hugo3132/EmlaLockSafe/README.md

# All documentation can be found under https://hugo3132.github.io/EmlaLockSafe/index.html

# EmlaLockSafe
This project is about controlling a cheap digital safe from a local hardware store using the API of emlalock https://www.emlalock.com. 

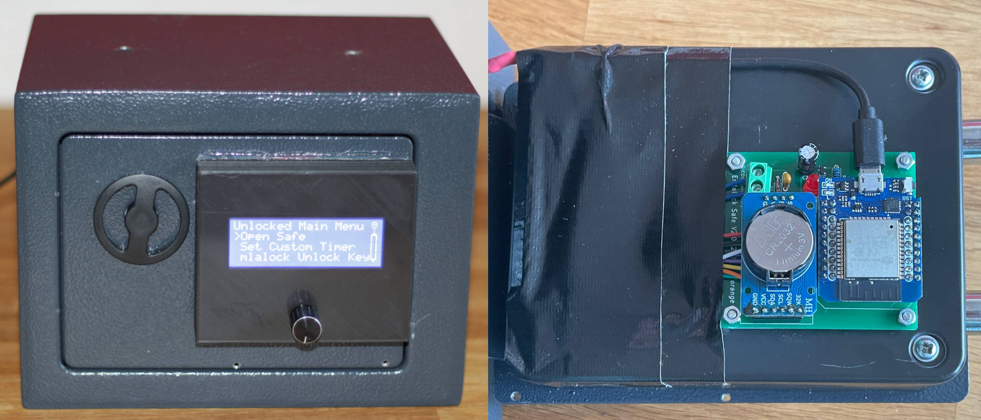
[picture p1: hardware/pictures/safe.jpg]
