hugo3132/EmlaLockSafe/hardware/Current Hardwarelist.txt

Ctrl:
https://www.amazon.de/AZDelivery-Bluetooth-Internet-Entwicklungsboard-kompatibel/dp/B08BTYCGVV

MicroUSB Breakout:
https://www.amazon.de/ZXUEZHENG-Adapterplatine-Micro-USB-Micro-USB-Schnittstelle-Breakout-Modul/dp/B07KS1RPMP

RTC:
https://www.amazon.de/AZDelivery-Real-Clock-DS3231-Parent/dp/B07ZQGBH14

Display:
https://www.amazon.de/AZDelivery-Bundle-2004-blau-Parent/dp/B07Z6CPTF4

Encoder: 
https://www.amazon.de/WayinTop-Encoder-Drehgeber-Drehwinkelgeber-Druckknopf/dp/B07T3672VK

Housing:
https://github.com/hugo3132/EmlaLockSafe/tree/master/hardware/3d%20printed%20parts/LCD%20Housing%20by%20hugo3132
source: https://cad.onshape.com/documents/5e5c868aceb5d7f8533767fd/w/02a796cf0a235e5fc50259cc/e/6ff6b7a15110ccacfdb04374

Brackets if you don't want to drill into the safe:
https://github.com/hugo3132/EmlaLockSafe/tree/master/hardware/3d%20printed%20parts/Emla%20Safe%20mounting%20brackets%20by%20naaitsab

Safe (must have some kind of electronic opening mechanism):
https://www.bauhaus.info/tresore/moebeleinsatztresor-security-box-mini/p/23519628
alternative: https://www.amazon.de/gp/product/B07X25MM4Y

Controller Board:
=================
1x Resistor 1k
1x Resitor 470
1x 5mm LED
1x Diode (e.g. 1N4148) 
1x MOSFET IRLML6244
1x 100µF Capacitor
1x 100nF Capacitor
Some connectors to connect the board to the modules (see pictures)
