hugo3132/EmlaLockSafe/hardware/pictures/coil.png

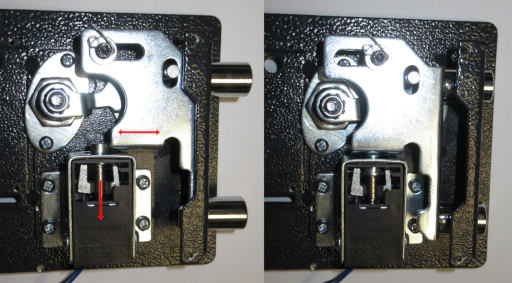
hardware/pictures/coil.png
