hugo3132/EmlaLockSafe/hardware/pictures/ControllerBoard.jpg

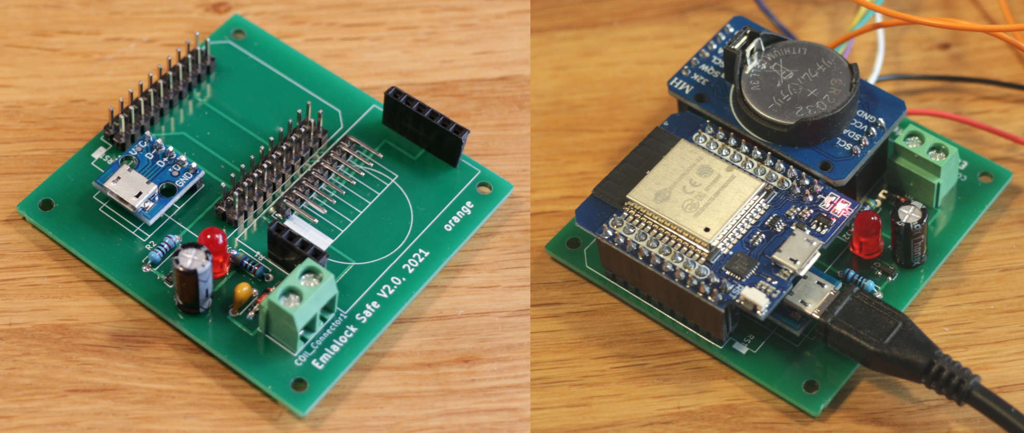
hardware/pictures/ControllerBoard.jpg
