hugo3132/EmlaLockSafe/hardware/pictures/DisplayModule_Back.jpg

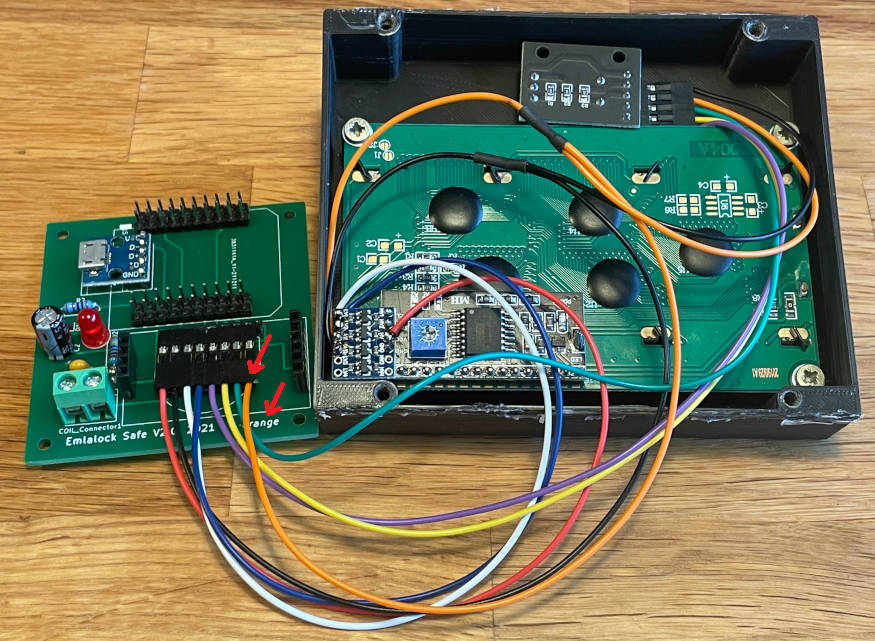
hardware/pictures/DisplayModule_Back.jpg
