hugo3132/EmlaLockSafe/hardware/pictures/DisplayModule_Front.jpg

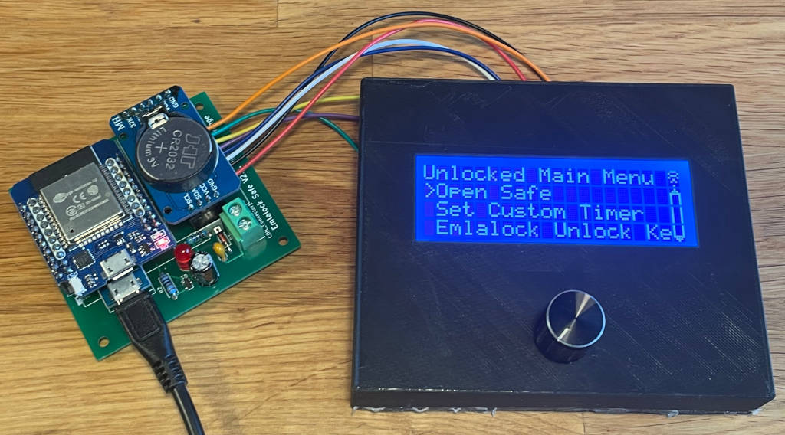
hardware/pictures/DisplayModule_Front.jpg
