hugo3132/EmlaLockSafe/hardware/pictures/FlashControllerBoard.png

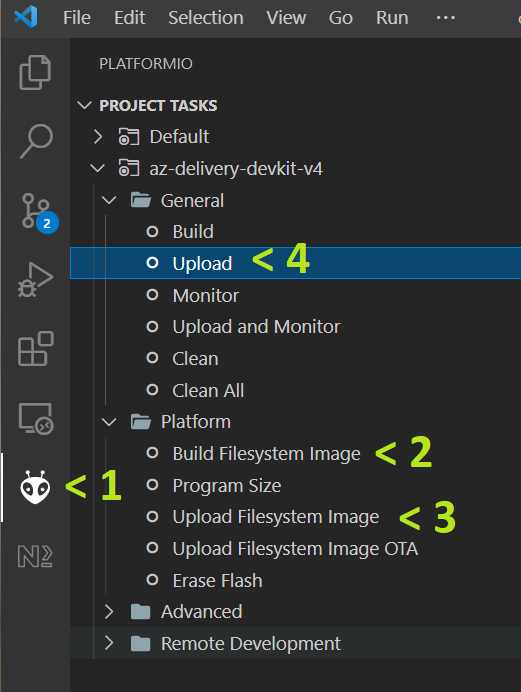
hardware/pictures/FlashControllerBoard.png
