hugo3132/EmlaLockSafe/hardware/3d printed parts/Emla Safe mounting brackets by naaitsab/EmlaSafe - Adapter Plate.jpg

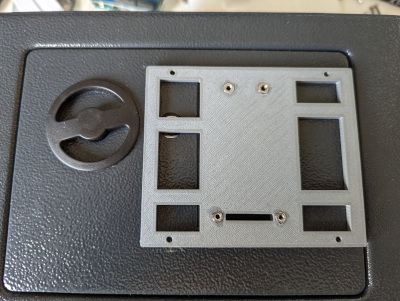
hardware/3d printed parts/Emla Safe mounting brackets by naaitsab/EmlaSafe - Adapter Plate.jpg
