hugo3132/EmlaLockSafe/hardware/3d printed parts/Emla Safe mounting brackets by naaitsab/EmlaSafe - PCB Holder.stl

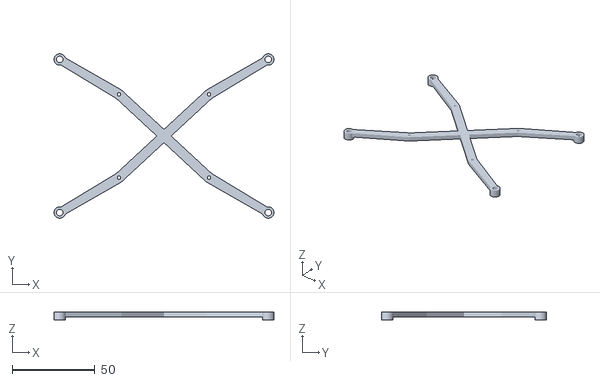
[picture p10: CAD file, 2022-04-09]
hardware/3d printed parts/Emla Safe mounting brackets by naaitsab/EmlaSafe - PCB Holder.stl
133.2 x 99.7 x 5.00
