hugo3132/EmlaLockSafe/hardware/3d printed parts/Housing v2 by hugo3132 inspired by naaitsab/Safe-Front Panel.stl

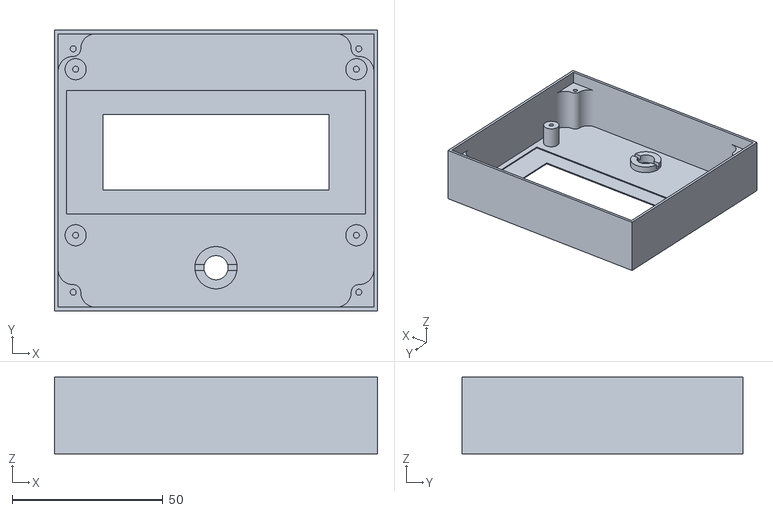
[picture p11: CAD file, 2022-05-24]
hardware/3d printed parts/Housing v2 by hugo3132 inspired by naaitsab/Safe-Front Panel.stl
107.0 x 93.0 x 25.5
