hugo3132/EmlaLockSafe/hardware/3d printed parts/LCD Housing by hugo3132/LCD_Housing.step

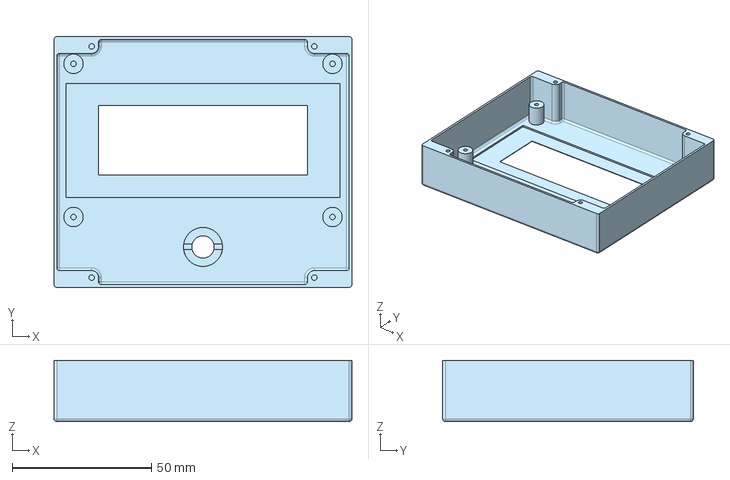
[picture p12: CAD file, 2022-04-09]
hardware/3d printed parts/LCD Housing by hugo3132/LCD_Housing.step
107.0 x 90.0 x 22.0 mm
