hugo3132/EmlaLockSafe/hardware/3d printed parts/Emla Safe mounting brackets by naaitsab/EmlaSafe - Adapter Plate Part 2.stl

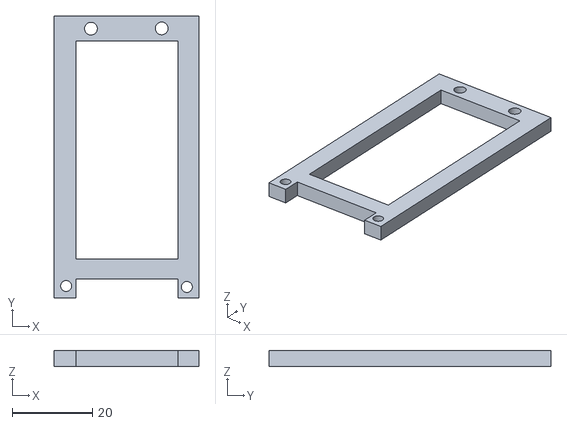
[picture p13: CAD file, 2022-04-09]
hardware/3d printed parts/Emla Safe mounting brackets by naaitsab/EmlaSafe - Adapter Plate Part 2.stl
36.2 x 70.5 x 4.00
