hugo3132/EmlaLockSafe/hardware/3d printed parts/Housing v2 by hugo3132 inspired by naaitsab/Safe.FCStd

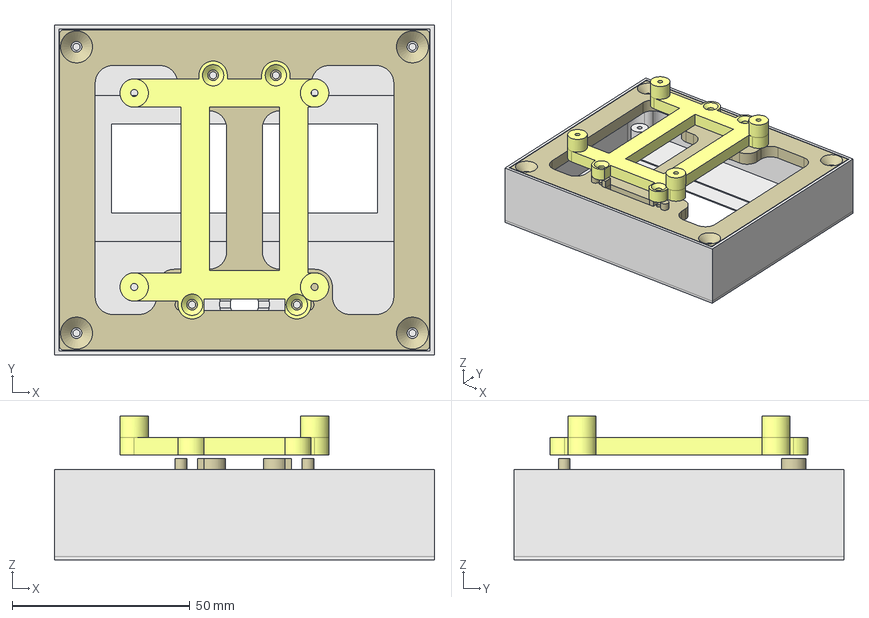
[picture p14: CAD file, 2022-05-24]
hardware/3d printed parts/Housing v2 by hugo3132 inspired by naaitsab/Safe.FCStd
107.0 x 93.0 x 40.5 mm
Front Panel
Mounting Frame 1
Mounting Frame 2
