hugo3132/EmlaLockSafe/hardware/3d printed parts/Emla Safe mounting brackets by naaitsab/EmlaSafe - Adapter Plate Part 1.stl

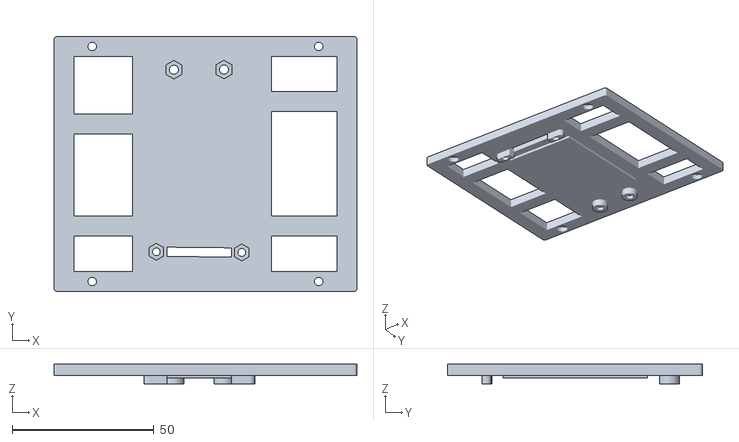
[picture p15: CAD file, 2022-04-09]
hardware/3d printed parts/Emla Safe mounting brackets by naaitsab/EmlaSafe - Adapter Plate Part 1.stl
107.0 x 90.0 x 7.00
