hugo3132/EmlaLockSafe/hardware/3d printed parts/Housing v2 by hugo3132 inspired by naaitsab/Safe-Mounting Frame 1.stl

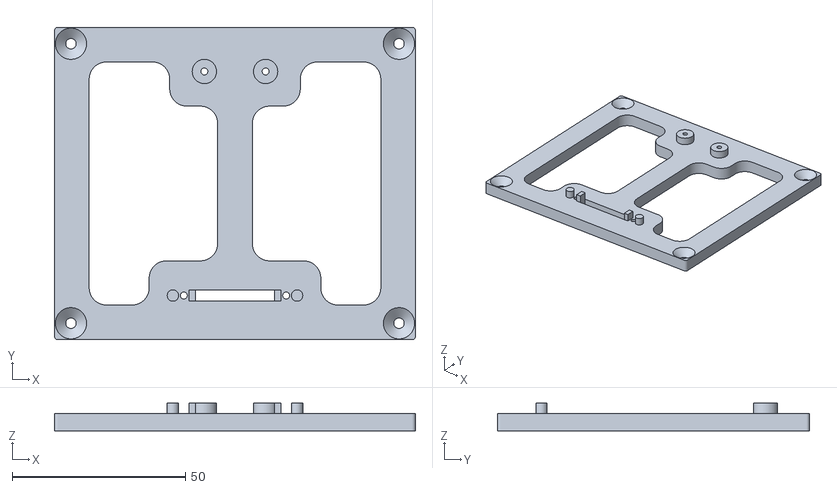
[picture p16: CAD file, 2022-05-24]
hardware/3d printed parts/Housing v2 by hugo3132 inspired by naaitsab/Safe-Mounting Frame 1.stl
104.1 x 90.1 x 8.00
