hugo3132/EmlaLockSafe/hardware/3d printed parts/Housing v2 by hugo3132 inspired by naaitsab/Safe-Mounting Frame 2.stl

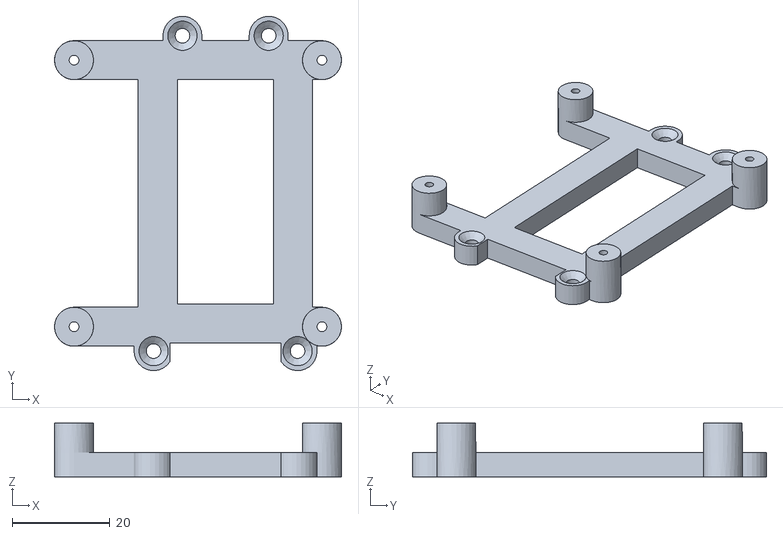
[picture p17: CAD file, 2022-05-24]
hardware/3d printed parts/Housing v2 by hugo3132 inspired by naaitsab/Safe-Mounting Frame 2.stl
58.8 x 72.6 x 11.0
