hugo3132/EmlaLockSafe/(list of files, cad)

Other CAD files:
hardware/3d printed parts/Emla Safe mounting brackets by naaitsab/EmlaSafe - Adapter Plate.f3d
hardware/3d printed parts/Emla Safe mounting brackets by naaitsab/EmlaSafe - PCB Holder .f3d
hardware/3d printed parts/LCD Housing by hugo3132/LCD_Housing.stl
