hugo3132/EmlaLockSafe/hardware/3d printed parts/Housing v2 by hugo3132 inspired by naaitsab/MountingInstructions.jpg

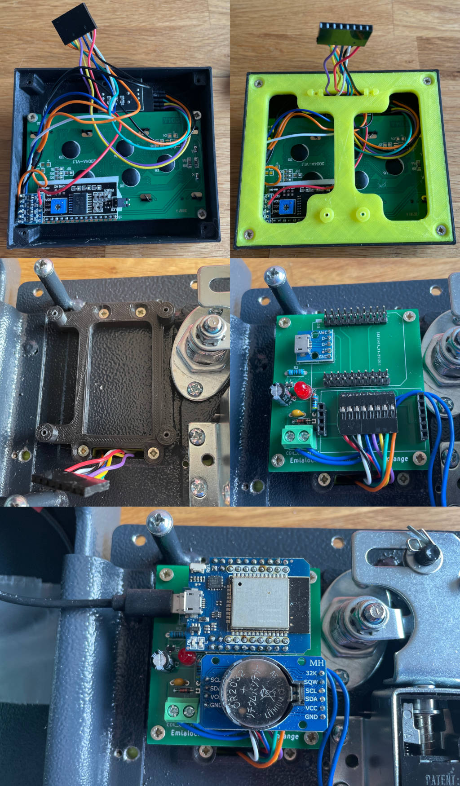
hardware/3d printed parts/Housing v2 by hugo3132 inspired by naaitsab/MountingInstructions.jpg
