hugo3132/EmlaLockSafe/hardware/pictures/WifiSetup.jpg

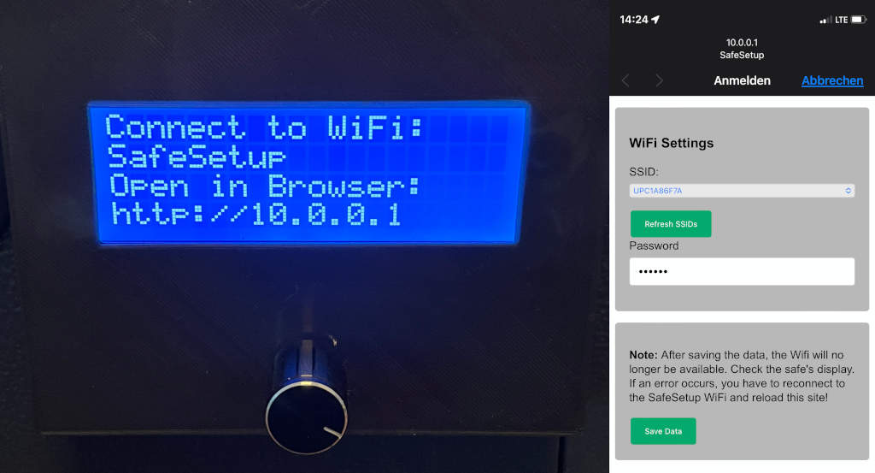
hardware/pictures/WifiSetup.jpg
