hugo3132/EmlaLockSafe/hardware/Schematics/EmlaLockSafe_Controller_Board.pdf

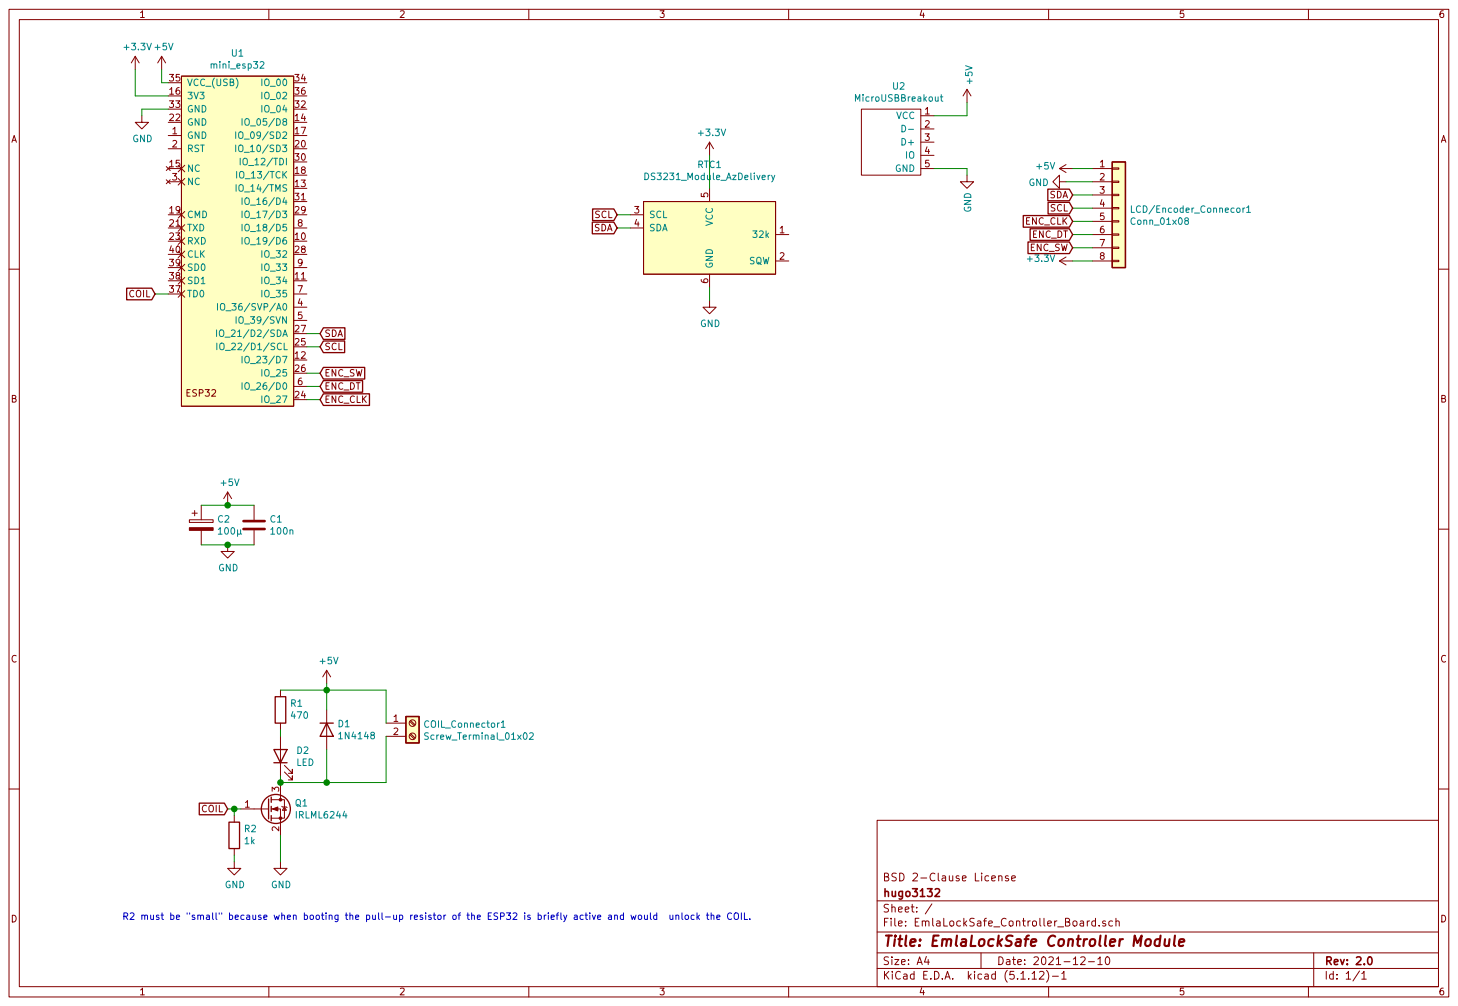
[picture p20: page 1]

COIL R2 must be "small" because when booting the pull-up resistor of the ESP32 is briefly active and would unlock the COIL.

File: EmlaLockSafe_Controller_Board.sch Sheet: / hugo3132 BSD 2-Clause License GND GND

Id: 1/1 Title: EmlaLockSafe Controller Module
