hugo3132/EmlaLockSafe/hardware/Schematics/EmlaLockSafe_IO_Module_Schematic.pdf

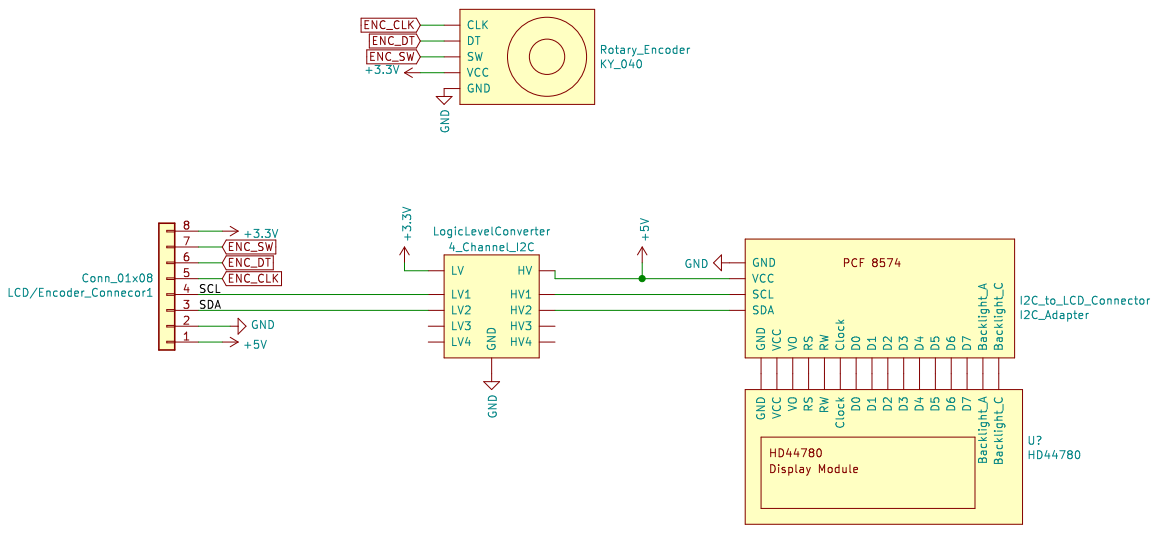
[picture p21: page 1]
