hugo3132/EmlaLockSafe/hardware/EmlaLockSafe_Controller_Board.kicad_pcb

## KiCad design hardware/EmlaLockSafe_Controller_Board.kicad_pcb (2022-01-06)

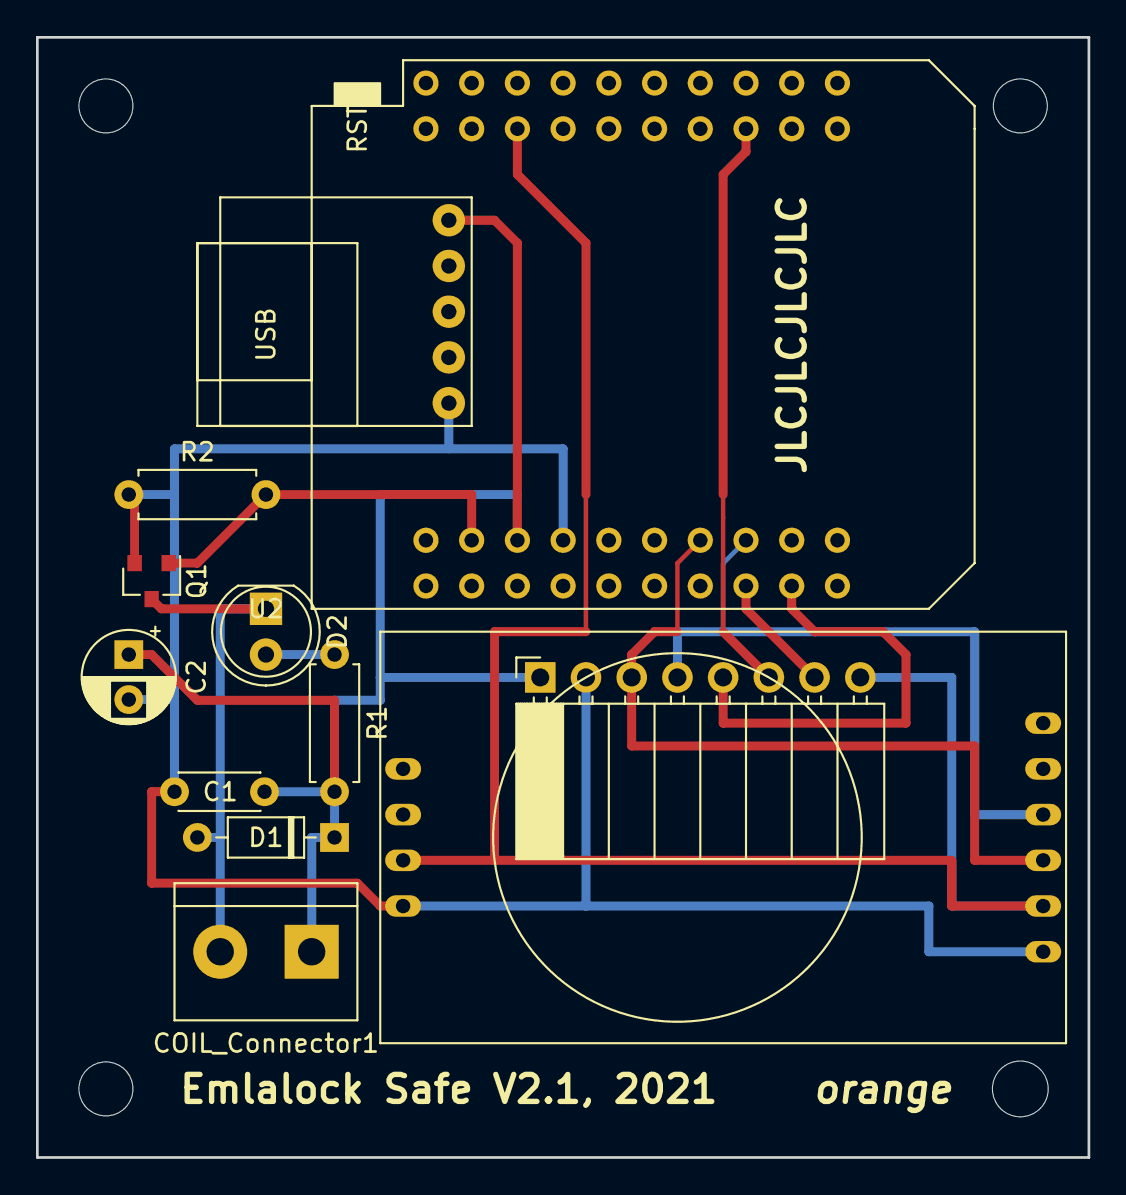
[picture p22: board EmlaLockSafe_Controller_Board.kicad_pcb from above]

Board: 2 copper layers, 58.4 x 62.2 mm, 12 parts (0 on the bottom side), 11 nets.

Parts:
C1: 100n; C_Disc_D4.3mm_W1.9mm_P5.00mm
C2: 100µ; CP_Radial_D5.0mm_P2.50mm
COIL_Connector1: Screw_Terminal_01x02; TerminalBlock_bornier-2_P5.08mm
D1: 1N4148; D_DO-35_SOD27_P7.62mm_Horizontal
D2: LED; LED_D5.0mm
LCD/Encoder_Connecor1: Conn_01x08; PinSocket_1x08_P2.54mm_Horizontal
Q1: IRLML6244; SOT-23
R1: 470; R_Axial_DIN0207_L6.3mm_D2.5mm_P7.62mm_Horizontal
R2: 1k; R_Axial_DIN0207_L6.3mm_D2.5mm_P7.62mm_Horizontal
RTC1: DS3231_Module_AzDelivery
U1: mini_esp32; ESP32_mini
U2: MicroUSBBreakout

Connections:
+3V3: LCD/Encoder_Connecor1.8, RTC1.5, U1.16
+5V: C1.1, C2.1, COIL_Connector1.1, D1.1, LCD/Encoder_Connecor1.1, R1.2, U1.35, U2.1
COIL: Q1.1, R2.2, U1.37
ENC_CLK: LCD/Encoder_Connecor1.5, U1.24
ENC_DT: LCD/Encoder_Connecor1.6, U1.6
ENC_SW: LCD/Encoder_Connecor1.7, U1.26
GND: C1.2, C2.2, LCD/Encoder_Connecor1.2, Q1.2, R2.1, RTC1.6, U1.33, U2.5
unnamed: COIL_Connector1.2, D1.2, D2.1, Q1.3
unnamed: D2.2, R1.1
SCL: LCD/Encoder_Connecor1.4, RTC1.3, U1.25
SDA: LCD/Encoder_Connecor1.3, RTC1.4, U1.27
