hugo3132/EmlaLockSafe/hardware/EmlaLockSafe.kicad_pcb

## KiCad design hardware/EmlaLockSafe.kicad_pcb (2020-08-19)

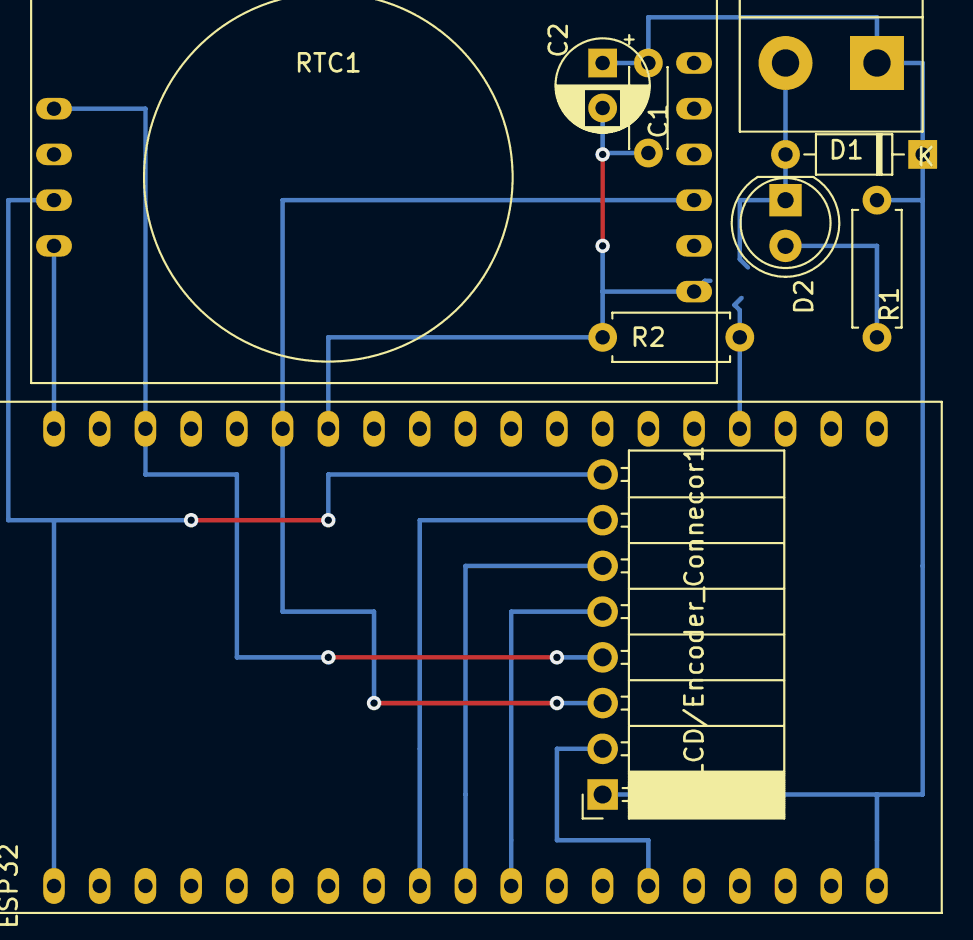
[picture p23: board EmlaLockSafe.kicad_pcb from above]

Board: 4 copper layers, 11 parts (1 on the bottom side), 11 nets.

Parts:
C1: 100n; C_Disc_D4.3mm_W1.9mm_P5.00mm
C2: 100µ; CP_Radial_D5.0mm_P2.50mm
COIL_Connector1: Screw_Terminal_01x02; TerminalBlock_bornier-2_P5.08mm
D1: 1N4148; D_DO-35_SOD27_P7.62mm_Horizontal
D2: LED; LED_D5.0mm
ESP32: ESP32_NodeMCU_Module_AzDelivery
LCD/Encoder_Connecor1: Conn_01x08; PinSocket_1x08_P2.54mm_Horizontal
Q1: IRLML6244; SOT-23
R1: 470; R_Axial_DIN0207_L6.3mm_D2.5mm_P7.62mm_Horizontal
R2: 1k; R_Axial_DIN0207_L6.3mm_D2.5mm_P7.62mm_Horizontal
RTC1: DS3231_Module_AzDelivery

Connections:
+3V3: ESP32.1, LCD/Encoder_Connecor1.8, RTC1.5
+5V: C1.1, C2.1, COIL_Connector1.1, D1.1, ESP32.19, LCD/Encoder_Connecor1.1, R1.2
COIL: ESP32.23, Q1.1, R2.2
ENC_CLK: ESP32.11, LCD/Encoder_Connecor1.5
ENC_DT: ESP32.10, LCD/Encoder_Connecor1.6
ENC_SW: ESP32.9, LCD/Encoder_Connecor1.7
GND: C1.2, C2.2, ESP32.GND, LCD/Encoder_Connecor1.2, Q1.2, R2.1, RTC1.6
unnamed: COIL_Connector1.2, D1.2, D2.1, Q1.3
unnamed: D2.2, R1.1
SCL: ESP32.36, LCD/Encoder_Connecor1.4, RTC1.3
SDA: ESP32.33, LCD/Encoder_Connecor1.3, RTC1.4
