hugo3132/EmlaLockSafe/(commit log)

2020-08-15 Added Blink Example to test board
2020-08-16 Updated Locked view Added Temperature to vview
2020-08-17 Update Current Hardwarelist.txt
    Added Safe
2020-08-19 Added schematic
    [EmlaLockSafe.kicad_pcb, EmlaLockSafe.sch]
2020-08-19 - Added 2 Defines describing the COIL State of the digital pin - Renamed defines of the encoder to the actual pin names - reordered the initialization of the modules to be able to enter the emergency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
2020-08-31 Updated schematics
    [EmlaLockSafe_Controller_Board.kicad_pcb, EmlaLockSafe_Controller_Board.sch, EmlaLockSafe_IO_Module.kicad_pcb, EmlaLockSafe_IO_Module.sch]
2020-08-31 added svg versions of schematic
2020-09-01 Added compressed STL file of case
2020-09-27 - added offline mode which disables the API - disabled API request if a manual timer is used
2020-09-27 Set mode if a manual timer is used
2020-09-27 fixed use of manual timer even without wifi
    [main.cpp]
2021-02-20 In case an session is aborted on emlalock the safe uses the last enddate and switches to manual mode until then.
2021-12-08 Added Library for ESP32 Mini
2021-12-11 Updated to V2
    [EmlaLockSafe_Controller_Board.kicad_pcb, EmlaLockSafe_Controller_Board.sch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]
2021-12-12 - Moved attaching and detaching interrupts to separate class - Added option to execute code without interrupts using lambdas
2021-12-12 - started moving configuration to a configuration::Configuration - added webserver to configure wifi settings
    [Configuration.h, ConfigurationServerBase.h]
2021-12-12 Added Configuration Webserver for Non-Wifi Settings
    [Configuration.h, ConfigurationServer.h, ConfigurationServerBase.h, ConfigurationServerView.h, configuration.txt]
2021-12-17 Switched to Captive Portal for the configuration of the WiFi settings
2021-12-17 moved pin configuration
    [ConfigurationServer.h]
2021-12-17 fixed some copy past errors
    [ConfigurationServerView.h]
2021-12-17 added 3D rendering of pcb
2021-12-17 Added Display Backlight Timeout as configurable parameter
    [Configuration.h, ConfigurationServer.h, ConfigurationServerView.h]
2021-12-17 Added configuration flag to automatically lock the safe after the time of an hygiene opening is over
    [Configuration.h, ConfigurationServer.h, configuration.txt]
2021-12-19 - added back entry - fixed wrong comparison for IP check
    [ConfigurationServerView.h]
2021-12-19 apply configuration changes without reboot
    [Configuration.h, ConfigurationServer.h]
2021-12-20 Updated Controller Board
2021-12-20 removed rendered PCB
2021-12-20 Added try catch to attach the interrupts again in case of an exception
2021-12-20 added menu entry to change the wifi settings
    [ConfigurationServerView.h]
2021-12-20 moved zones.json to ConfigurationServer
    [ConfigurationServer.h, ConfigurationServerBase.h]
2021-12-20 updated formatting
    [ConfigurationServerView.h]
2021-12-20 moved a few labels
    [EmlaLockSafe_Controller_Board.kicad_pcb]
2021-12-27 Update Current Hardwarelist.txt
    Added link to origninal controller board which is available again
2021-12-27 Update Current Hardwarelist.txt
2021-12-28 Added the option to limit the time span when the safe can be opened
    [Configuration.h, ConfigurationServer.h, configuration.txt]
2021-12-29 Moved Emergency Key to configuration and made it visible in the configuaration server
    [Configuration.h, ConfigurationServer.h, configuration.txt]
2021-12-30 Added an option to reset the configuration
    [Configuration.h]
2022-01-03 Added option to remote control the safe using the browser
    [ConfigurationServer.h, ConfigurationServerView.h]
2022-01-03 added option to reflect backlight state of LCD in remote control mode
    [ConfigurationServer.h]
2022-01-06 - Changed mounting holes to 3mm - Changed 5V & 3,3V wiring to allow to use the PCB without the RTC module
    [EmlaLockSafe_Controller_Board-B_Cu.gbl, EmlaLockSafe_Controller_Board-B_Mask.gbs, EmlaLockSafe_Controller_Board-B_Paste.gbp, EmlaLockSafe_Controller_Board-B_SilkS.gbo, EmlaLockSafe_Controller_Board-Edge_Cuts.gm1, EmlaLockSafe_Controller_Board-F_Cu.gtl, EmlaLockSafe_Controller_Board-F_Mask.gts, EmlaLockSafe_Controller_Board-F_Paste.gtp]
2022-01-06 made behavior configurable if a session is ended as failed session
    [Configuration.h, ConfigurationServer.h, configuration.txt]
2022-03-18 Added Optional Switch which can be soldered to the ESP to enable the configuration server when the safe is open
    [Configuration.h]
2022-04-08 added stl of LCD housing
    [LCD_Housing.stl]
2022-04-08 updated link to STL file
2022-04-09 added mounting brackets created by naaitsab
    [EmlaSafe - Adapter Plate.f3d, EmlaSafe - PCB Holder .f3d]
2022-04-09 reorganized 3d printed parts, added stl files for adapter plate and pcb holder
    [EmlaSafe - Adapter Plate Part 1.stl, EmlaSafe - Adapter Plate Part 2.stl, EmlaSafe - PCB Holder.stl, LCD_Housing.step, LCD_Housing.stl]
2022-05-24 Added a new version of the housing
    [Safe-Front Panel.stl, Safe-Mounting Frame 1.stl, Safe-Mounting Frame 2.stl, Safe.FCStd]
2022-05-24 reverted accidentally removed file
    [RealTimeClock.h]
